nikobago/pcb_ai_uwb_smart_flashlight/ai_uwb_smart_flashlight/Project Outputs for Leif_Lamp_Circuit/ai_uwb_smart_flashlight.xlsx

Comment | Description | Designator | Quantity | Footprint
100nF 50V | C0805C100JDGACAUTO | C10, C15 | 2 | 0805C
100nF 16V | CC0603ZRY5V7BB104 | C11 | 1 | C0603
1uF 16V | C0805J105K4RACAUTO | C12 | 1 | C0805
33uF 63V | EEHZA1J330P | C13 | 1 | SM_RADIAL_8MM
68uF 10V | 10SVPC68M | C16 | 1 | SM_RADIAL_5MM
56pF 50V | VJ0805A560FXACW1BC | C17 | 1 | 0805C
47nF 16V | 0805X7R473KT2AT | C18 | 1 | C0805
22uF 16V | CM105X5R226M16AT | C19, C20 | 2 | C0603
10uF 16V | 0603YD106MAT2A | C14,C21, C27 | 3 | C0603
820pF 50V | C0402C821J5GACAUTO | C22 | 1 | 0402
4.7uF 25V | CC0805MKX7R8BB475 | C23 | 1 | C0805
10uF 25V | 0805X7R106KT1AT | C24 | 1 | 0805C
2.2uF 25V | KAF21KR71E225KU | C25 | 1 | 0805C
100nF 16V | CC0603ZRY5V7BB104 | C26, C28, C30 | 3 | C0603
47uF 35V | CAPAE660X550N | C29 | 1 | CAPAE660X550N
100pF 16V | 0603YC101KAT2A | C31 | 1 | C0603
39nF 25V | 0603YC101KAT2A | C32 | 1 | C0603
100nF 50V | CML0603X7R104KT50V | C33 | 1 | 0603C
100uF 16V | 865230345005.00 | C34 | 1 | CAPAE660X770N
LED3 | LSM0603463V | D1, D2 | 2 | C0603
1N4001W-T | '1N4001W-T | D3 | 1 | SODFL3818X130N
CDBC560-G | CDBC560-G | D4 | 1 | DIOM7959X262N
LED | Wire solder preprations/dont solder | D6, D7, D8, D9 | 4 | SolderWires
5A | 0407005.WRA | F1 | 1 | FUSC3216X78N
USB Type C | 10164359-00011LF | J1 | 1 | 1016435900011LF
Molex 3 PIN | 440052-3 | J2 | 1 | Batt
LicheeRV Pins | 22-28-4142 (SOLDER IF CUBIE IS NOT SELECTED) | J3, J4 | 2 | HDRV14W63P0X254_1X14_3556X250X950P
ESP32_Header_12 | 12 Pin CES-112-02-S-S 20 Pin 1-535541-8 | J5 | 1 | 12P-2.54
Cubie Header | 61304021821(SOLDER IF LicheeRV IS NOT SELECTED) | J6 | 1 | 40Pin
Switch | Wire solder preprations/dont solder | J7 | 1 | SWITCH SOLDER
Open | Conn 42375-1855 + jumper 60900213621, Jumper 42375-1855 | JP1, JP2, JP6, JP7 | 4 | HDRV2W87P0X254_1X2_768X249X1494P - duplicate
15uH | SRR1206-150ML | L1 | 1 | SRR1280
1uH | VLS5045EX-1R0N | L2 | 1 | VLS5045EX330M
3.3uH | PA2240.332NLT | L3 | 1 | PA2240332NLT
47uH | HCMA1707-470-R | L4 | 1 | INDPM172168X700N
VibroMotor | 474-ROB-08449' | M1 | 1 | SolderWires
MOSFET (N-Channel) | 2N7002ET7G | Q1 | 1 | SOT96P237X111-3N
MOSFET P-CH 30V 5A | RQ5E050ATTCL | Q2 | 1 | SOT95P280X100-3N
2K | ERJ-PA3J202V | R1, R14, R20, R35, R36, R37 | 6 | R0603
10K | RCA060310K0FKEAHP | R8 | 1 | 0603
10k | RCA060310K0FKEAHP | R11 | 1 | R0603
383R | ERJ-PA3F3830V | R13 | 1 | R0603
100k | RCA0603100KFKEAHP | R15 | 1 | 0402
133k | ERJ-PA3F1333V | R16 | 1 | 0201
18.7k | ERJ-PA3F1872V | R17 | 1 | 0201
1M | CRCW06031M00FKED | R18 | 1 | 0603
19.1k | ERJ-PA3F1912V | R19 | 1 | 0402
620k | ERJ-PA3F6203V | R23 | 1 | 0603
158k | ERJ-PA3F1583V | R28 | 1 | 0603
100k | RCA0603100KFKEAHP | R29 | 1 | R0603
931k | CRCW0603931KFKTA | R30 | 1 | R0603
44.2k | ERJ-PA3F4422V | R31 | 1 | R0603
48.7k | ERJ-PA3F4872V | R32 | 1 | R0603
150mOhm | RL0603FR-070R15L | R33 | 1 | R0603
50mOhm | ERJ-3BWFR056V | R34 | 1 | R0603
Open | Circuit Breaker | SB1 | 1 | SB_0603
TPS61288LRQQR_1 | TPS61288LRQQR_1 | U4 | 1 | CONV_TPS61288LRQQR
BQ25886RGET | BQ25886RGET | U5 | 1 | RGE0024H
TPS54335ADDAR | TPS54335ADDAR | U6 | 1 | IC_TPS54335ADDAR
AL8843SP-13 | AL8843SP-13 | U7 | 1 | SOIC127P600X163-9N
ICM-42605 | ICM-42605 | U8 | 1 | IIM42352
