nikobago/pcb_ai_uwb_smart_flashlight/(list of files, drawings)

Other design files:
ai_uwb_smart_flashlight/ai_uwb_smart_flashlight.PrjPcb
ai_uwb_smart_flashlight/MCU and Peripherals.SchDoc
ai_uwb_smart_flashlight/Power supply.SchDoc
ai_uwb_smart_flashlight/Schlib1.SchLib
Camera_to_AI_Flex_Pcb/Camera_to_AI_Flex_Pcb.PrjPcb
Camera_to_AI_Flex_Pcb/Lib.SchLib
Camera_to_AI_Flex_Pcb/PCB1.PcbDoc
Camera_to_AI_Flex_Pcb/PcbLib1.PcbLib
Camera_to_AI_Flex_Pcb/Sheet1.SchDoc
LED_HeatSink_PCB/LED_HeatSink_PCB.PrjPcb
LED_HeatSink_PCB/Wiring.SchDoc
