nikobago/pcb_ai_uwb_smart_flashlight/(commit log)

2025-11-25 added heatsink and flex pcb
    [Camera_to_AI_Flex_Pcb.PrjPcb, LED_HeatSink_PCB.PrjPcb, Lib.SchLib, PCB1.PcbDoc, PcbLib1.PcbLib, Sheet1.SchDoc, Wiring.SchDoc]
2025-11-25 added main pcb
    [MCU and Peripherals.SchDoc, Power supply.SchDoc, Schlib1.SchLib, WiringSchematic.SchDoc, ai_uwb_smart_flashlight.PrjPcb]
2025-12-04 Add files via upload
    Adding BOM and Pick and place files
    [ai_uwb_smart_flashlight.xlsx]
2025-12-04 Change in the wiring document, removed the templates
    [MCU and Peripherals.SchDoc, Power supply.SchDoc, WiringSchematic.SchDoc, ai_uwb_smart_flashlight.PrjPcb]
